bestel74/xprog_calculator/Schematic/BOM_DecHexBin_2020-10-09_15-29-10.csv

ID | Name | Designator | Footprint | Quantity | Manufacturer Part | Manufacturer | Supplier | Supplier Part | LCSC Assembly
1 | D-R060306L3-KS2 | LED_VCC,LED_MODE_HEXADECIMAL,LED_MODE_LSB_MSB,LED_MODE_DECIMAL,LED_MODE_BINARY | LED0603-RD | 5 | D-R060306L3-KS2 | ARKLED | LCSC | C118330
2 | SR420281N/33 | LED_DEC_01,LED_HEX_02,LED_DEC_02,LED_DEC_03,LED_HEX_01 | LED-SEG-TH_12P-L32.1-W10.0-P2.54-S7.62-BL | 5 | SR420281N/33 | Wuxi ARK Tech Elec | LCSC | C252224
3 | 13pF | C1,C2 | C0805 | 2 | 0805CG130J500NT | FH(Guangdong Fenghua Advanced Tech) | LCSC | C501858
4 | U254-051T-4BH83-F1S | USB1 | MICRO-USB-SMD_U254-051T-4BH83-F1S | 1 | U254-051T-4BH83-F1S | XKB Enterprise | LCSC | C397452
5 | CH423S | CH423_HEX,CH423_BIN,CH423_DEC | SOP-28_L17.9-W7.5-P1.27-LS10.3-BL | 3 | CH423S | WCH | LCSC | C111663
6 | TS-1102S-C-D-B | SW_0,SW_PLUS,SW_MINUS,SW_MULT,SW_DIV,SW_SETTING,SW_C,SW_MODE,SW_EQUAL,SW_CLEAR,SW_D,SW_E,SW_F,SW_B,SW_A,SW_9,SW_8,SW_4,SW_5,SW_6,SW_7,SW_3,SW_2,SW_1 | KEY-SMD_4P-L6.0-W6.0-P4.50-LS8.6 | 24 | TS-1102S-C-D-B | XKB Enterprise | LCSC | C381040
7 | STM32F401RBT6 | MICRO-CONTROLLER | LQFP-64_L10.0-W10.0-P0.50-LS12.0-BL | 1 | STM32F401RBT6 | STMicroelectronics | LCSC | C75278 | Yes
8 | 25MHz | HSE | OSC-SMD_4P-L3.2-W2.5-BL | 1 | X1E000021013912 | EPSON | LCSC | C91750 | Yes
9 | MST-22D18G2 3J | PWR_SW | SW-SMD_MST-22D18G2 3J | 1 | MST-22D18G2 3J | SHOU HAN | LCSC | C668586
10 | BL9110-330BPFB | REG_3.3V | SOT-223_L6.5-W3.5-P2.30-LS7.0-BR | 1 | BL9110-330BPFB | BL | LCSC | C169246 | Yes
11 | 12251103CNG0S115001 | HEADER_VBAT_VUSB | HDR-TH_3P-P2.54-V | 1 | 12251103CNG0S115001 | JILN | LCSC | C429954
12 | 270 | R11,R10,R9,R8,R7 | R0805 | 5 | CR0805F82700G | LIZ | LCSC | C101615
13 | 10k | R6,R5,R4,R3,R2,R1 | R0805 | 6 | QR0805J10KP05 | EVER OHMS | LCSC | C149881
14 | PZ200V-11-08P | HEADER_JTAG | HDR-TH_8P-P2.00-V-M | 1 | PZ200V-11-08P | XFCN | LCSC | C541862
15 | TJ-S1615SW6TGLCBG-A5 | LED24,LED06,LED05,LED04,LED03,LED02,LED08,LED01,LED9,LED10,LED11,LED07,LED00,LED12,LED13,LED31,LED30,LED29,LED28,LED27,LED26,LED25,LED14,LED23,LED22,LED21,LED20,LED19,LED18,LED17,LED16,LED15 | LED-ARRAY-SMD_4P-L1.6-W1.5-TR-RD_TJ-S1615SW6TGLCRB-A5 | 32 | TJ-S1615SW6TGLCBG-A5 | TOGIALED | LCSC | C273609
16 | 100nF | C12,C14,C10,C19,C18,C16,C15,C13 | C0805 | 8 | TCC0805X7R104K500DTS | CCTC | LCSC | C376924
17 | 10uF | C20 | C0805 | 1 | CC0805KKX5R7BB106 | YAGEO | LCSC | C89827
18 | 4.7uF | C9,C11 | C0805 | 2 | CC0805ZRY5V6BB475 | YAGEO | LCSC | C326951
19 | 2.2uF | C21 | C0805 | 1 | CC0805KKX5R6BB225 | YAGEO | LCSC | C327027
20 | 1uF | C17 | C0805 | 1 | TCC0805X7R105K500DTB | CCTC | LCSC | C282736
