bestel74/xprog_calculator/Schematic/Schematic_DecHexBin_2020-10-09_15-28-59.pdf

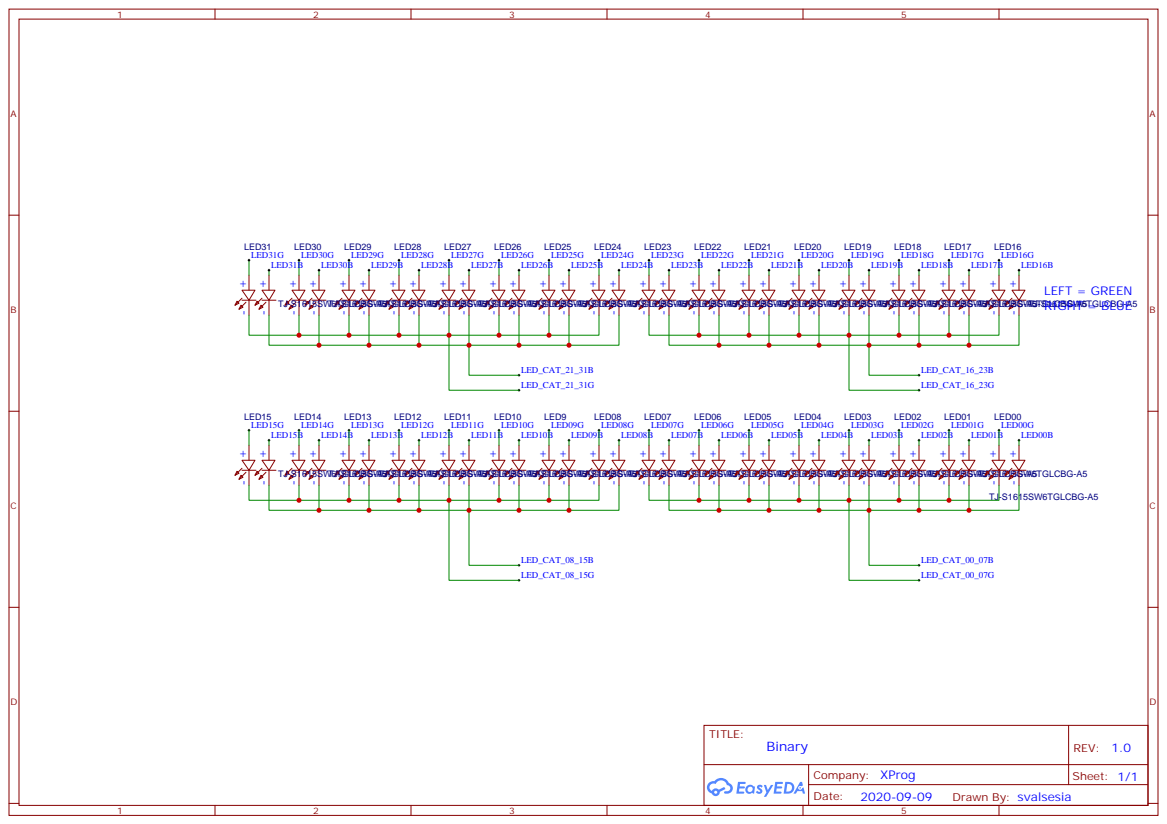
[picture p1: page 1]

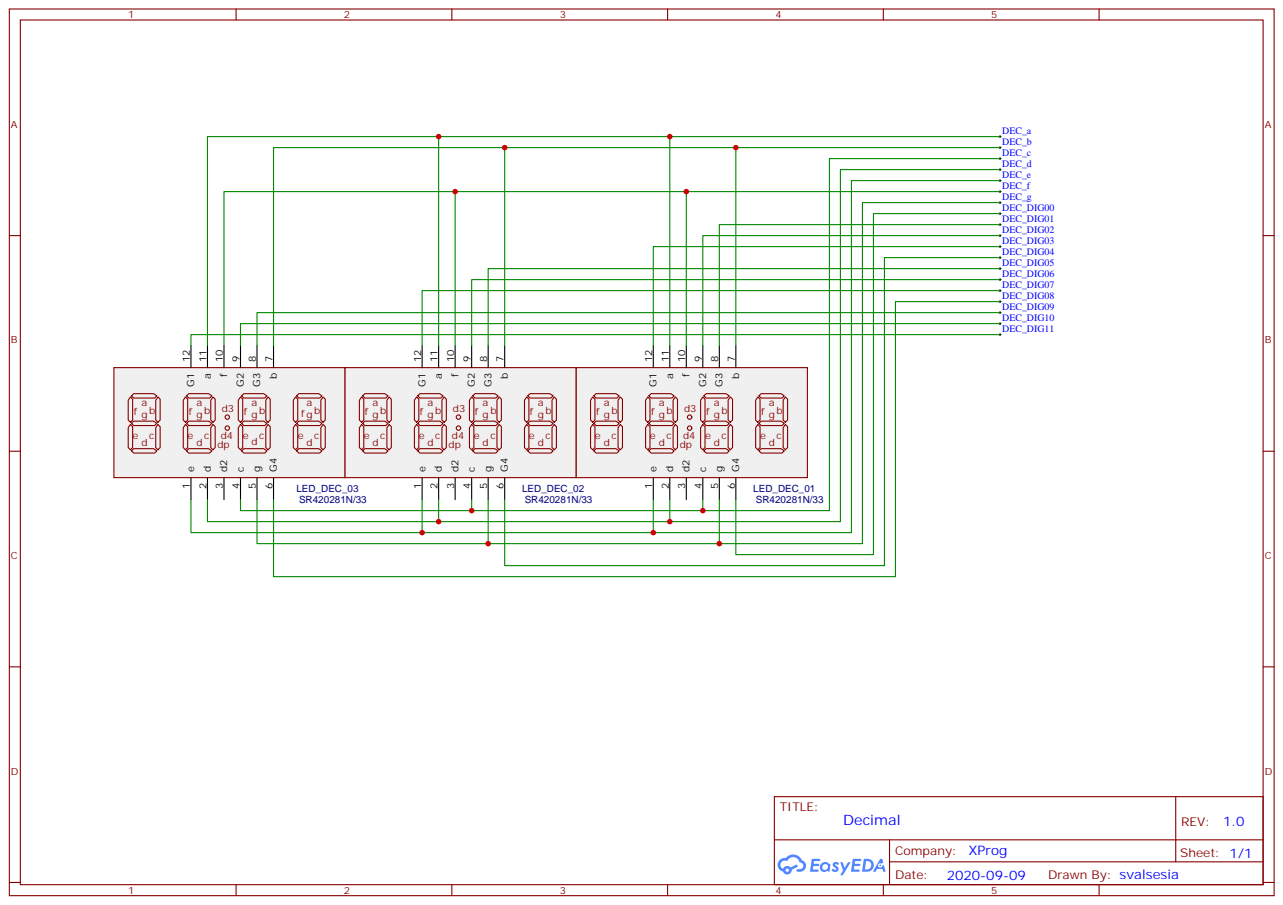
[picture p2: page 2]

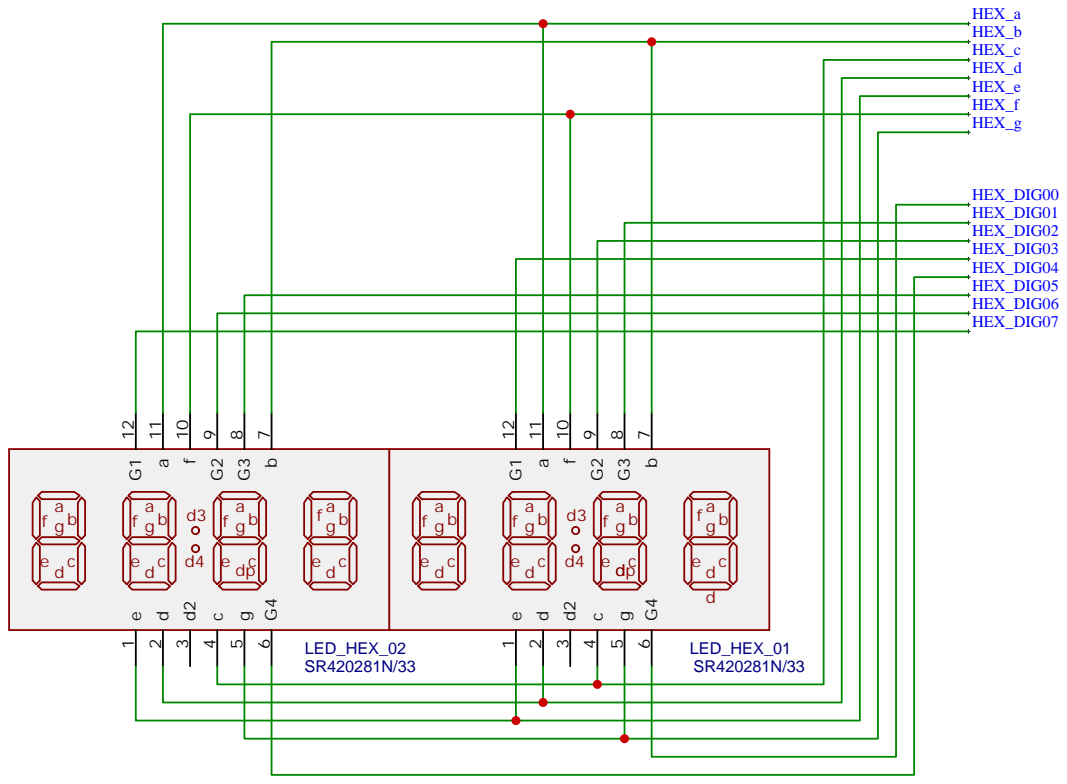
[picture p3: page 3]

## VCC

## GND

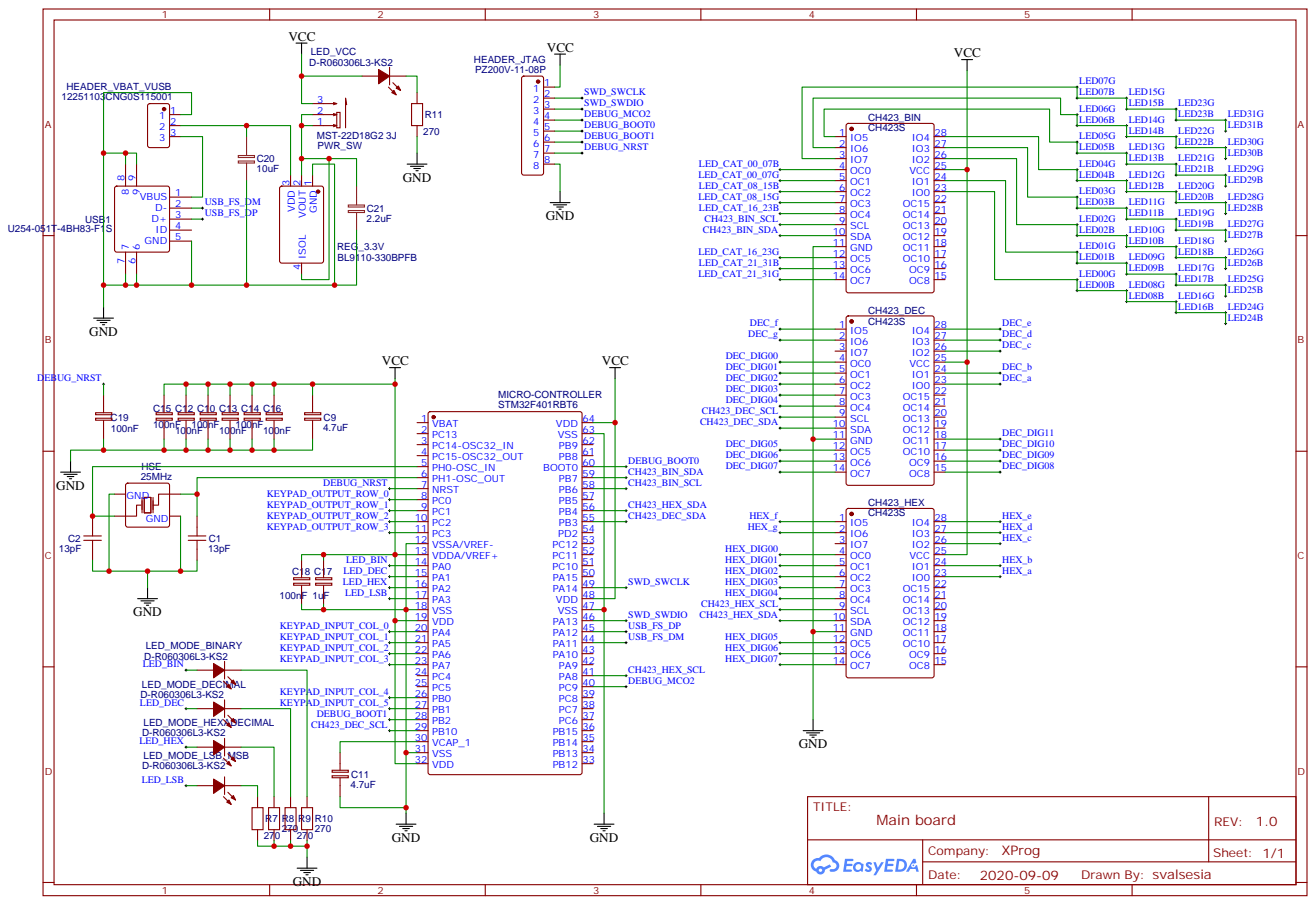
[picture p4: page 4]

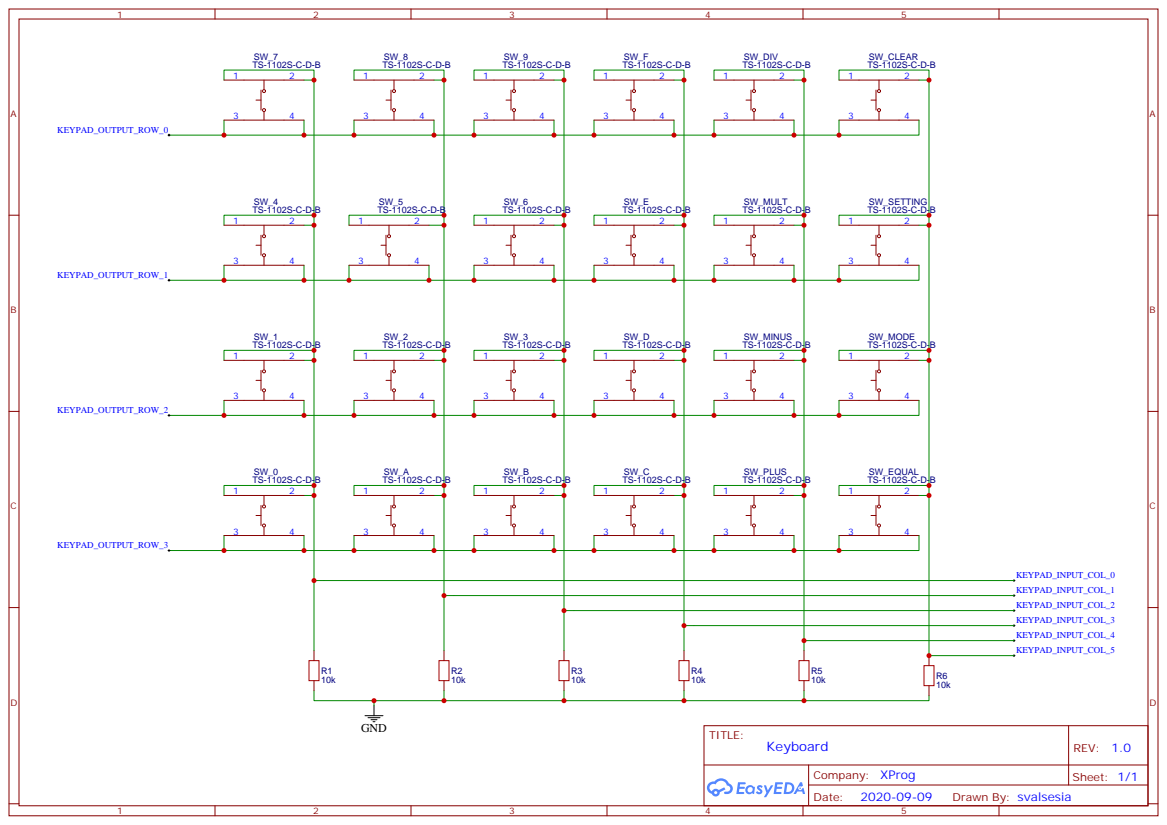
[picture p5: page 5]
