bestel74/xprog_calculator/Schematic/Schematic_DecHexBin_2020-10-08_14-23-01.pdf

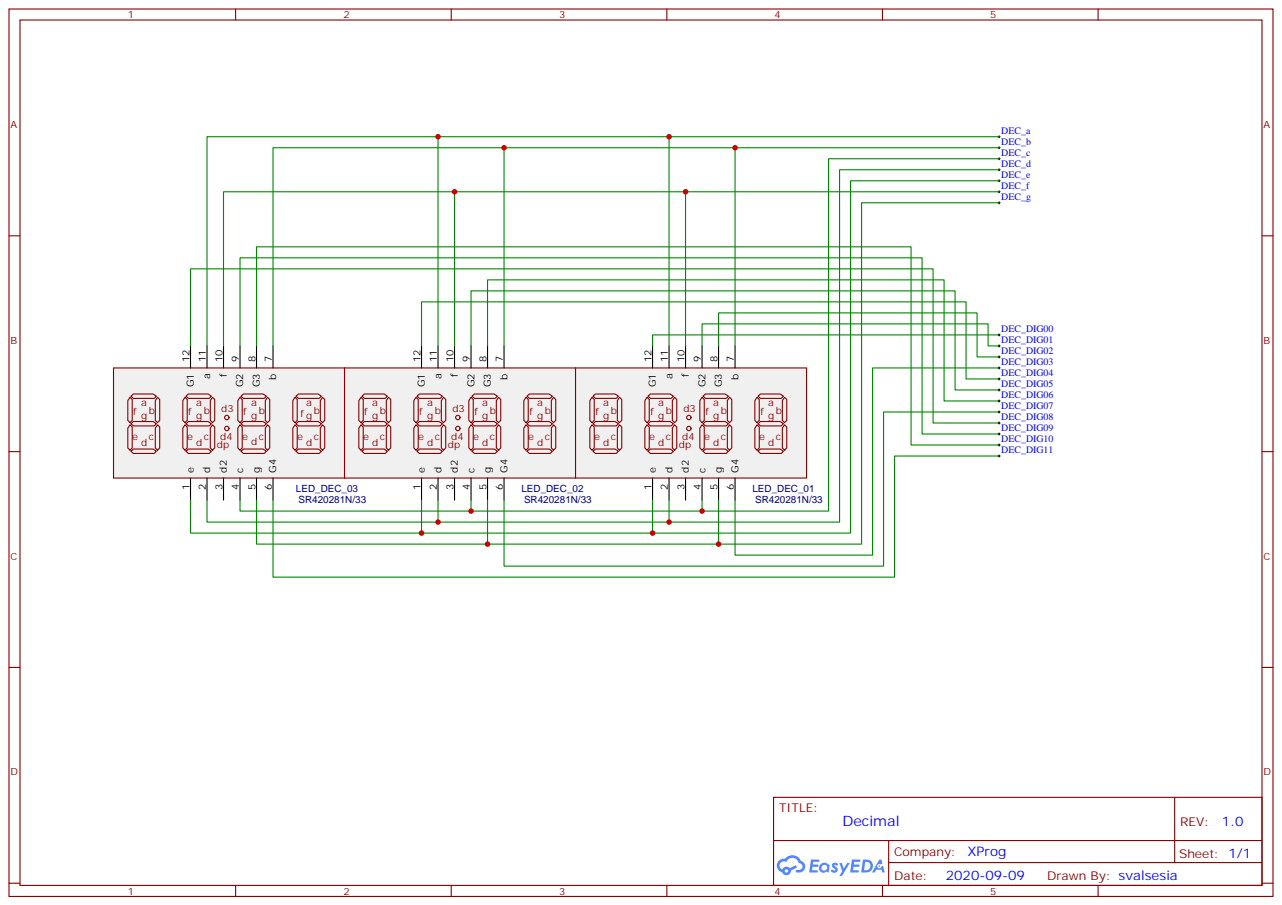
[picture p6: page 2]

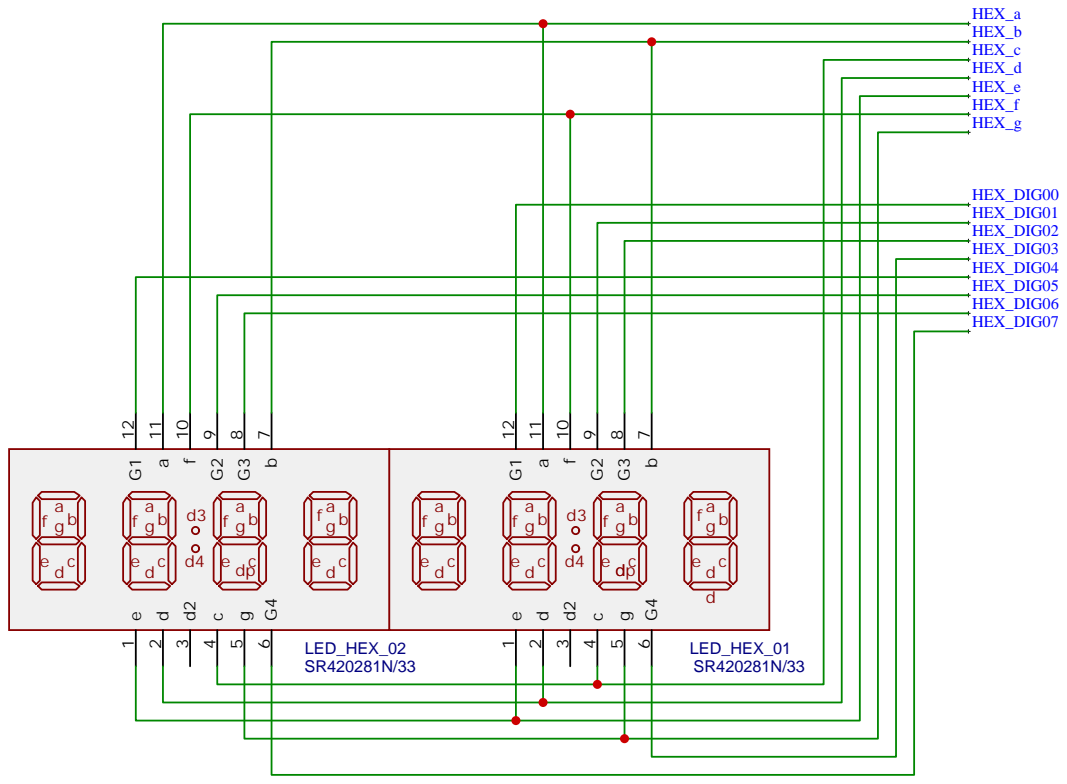
[picture p7: page 3]

## VCC

## GND

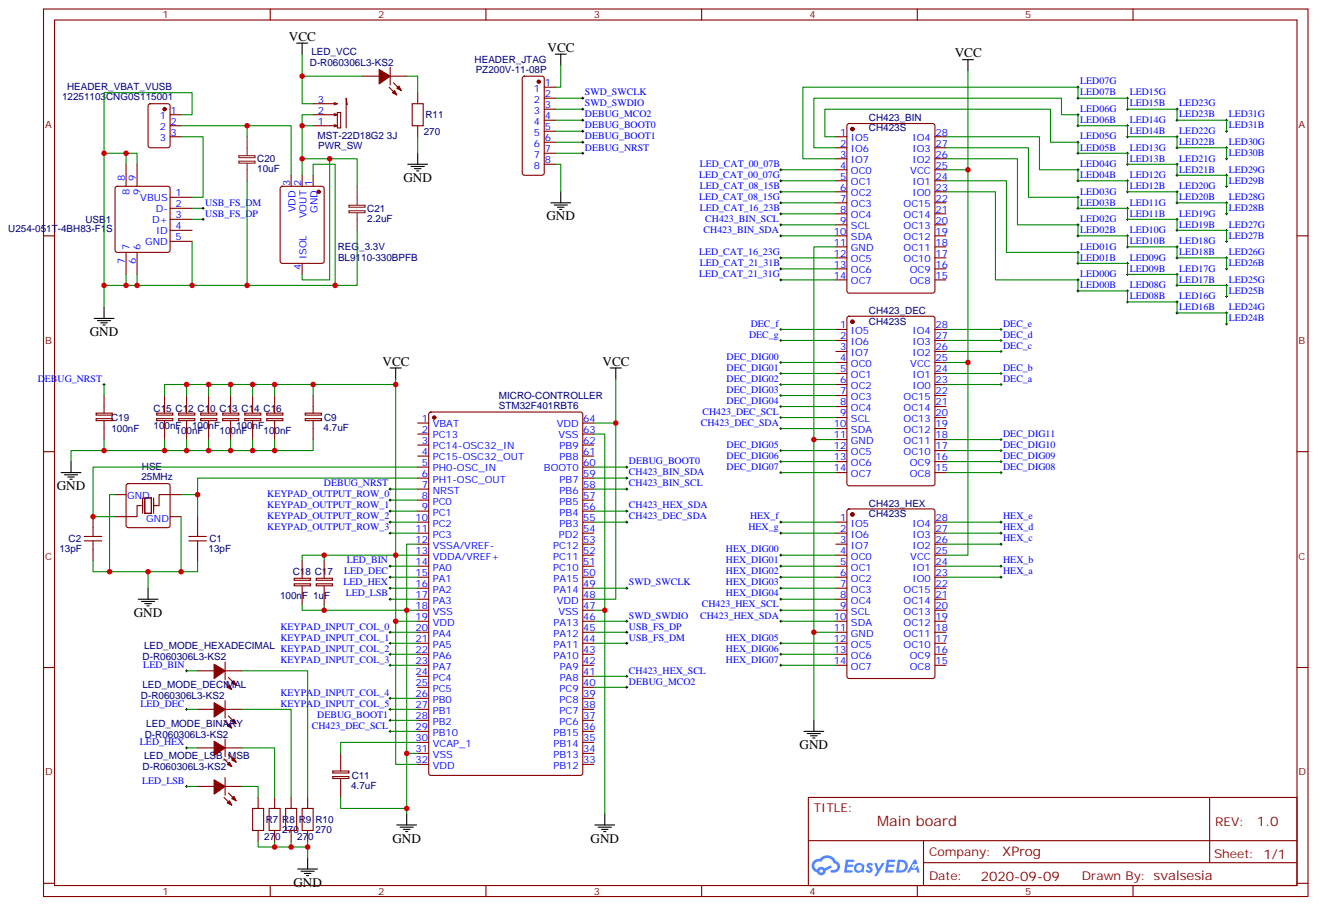
[picture p8: page 4]

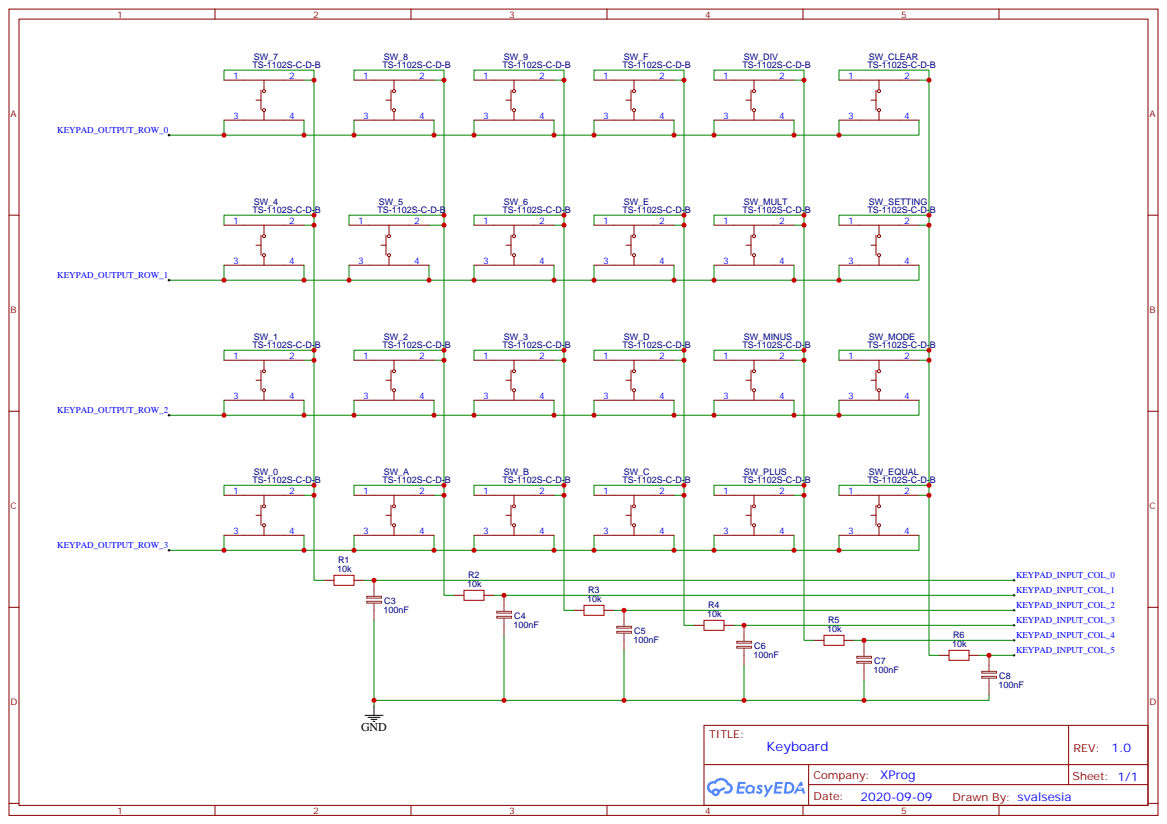
[picture p9: page 5]
