bestel74/xprog_calculator/(list of files, drawings)

Other design files:
Schematic/PCB_V1_WIP_2020-10-08_14-27-14.json
Schematic/PCB_V2_WIP_2020-10-09_15-29-44.json
