bestel74/xprog_calculator/(commit log)

2020-10-08 [WIP] Lot of fix
    - Fix PCB wrong power supply VDDA/VREF+
    - Fix LDO 3.3v pad 4 = Vout
    - Fix FreeRTOS pool and queue creation
    [BOM_DecHexBin_2020-09-17_11-38-52.csv, BOM_DecHexBin_2020-10-08_14-23-07.csv, PCB_V1_WIP_2020-10-08_14-27-14.json, PickAndPlace_PCB_V1_WIP_2020-09-17_11-40-58.csv, PickAndPlace_PCB_V1_WIP_2020-10-08_14-24-33.csv]
2020-10-09 Release V2
    - Fix keyboard debounce
    - Fix Digit order
    - Fix Firmware
    [BOM_DecHexBin_2020-10-08_14-23-07.csv, BOM_DecHexBin_2020-10-09_15-29-10.csv, PCB_V2_WIP_2020-10-09_15-29-44.json, PickAndPlace_PCB_V1_WIP_2020-10-08_14-24-33.csv, PickAndPlace_PCB_V2_WIP_2020-10-09_15-30-29.csv]
2020-10-09 Fix 'Display thread' realtime to low priority
